zyssai/GPIO-4-Cars/README.md

# GPIO'4'Cars

This project, named GPIO'4'Cars, was designed to easily connect your Odroid N2/N2+ board, with your car.

More information here:

https://forum.odroid.com/viewtopic.php?f=182&t=45350
