zyssai/GPIO-4-Cars/howto/Howto_bootanim.txt

remount
cp /storage/emulated/0/Download/boot-logo.bmp.gz /odm/
chmod 755 /odm/boot-logo.bmp.gz
cp /storage/emulated/0/Download/bootanimation.zip /system/product/media/
chmod 755 /system/product/media/bootanimation.zip
