zyssai/GPIO-4-Cars/howto/Howto_root.txt

install magisk apk:

https://github.com/topjohnwu/Magisk/releases

From computer, connected with usb otg port:

adb shell

cd /storage/emulated/0/Download

dd if=/dev/block/boot of=boot.img

* patch boot.img with magisk app

dd of=/dev/block/boot if=patched_boot.img
