zyssai/GPIO-4-Cars/v1.5c/Laguna3_SWC_wiring.png

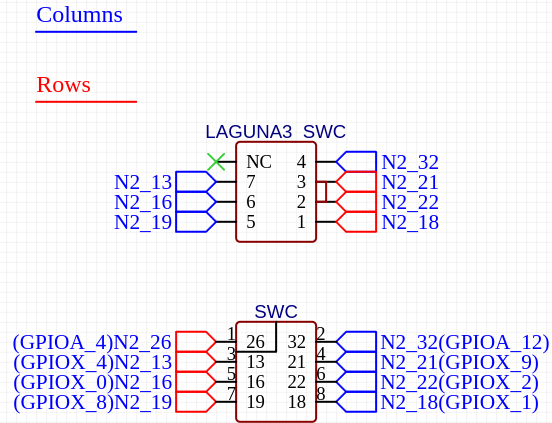
v1.5c/Laguna3_SWC_wiring.png
