zyssai/GPIO-4-Cars/v1.5c/Schematic_GPIO'4'Cars_v1.5c_2024-02-28.pdf

## GPIO INPUTS

## POWER MOSFET

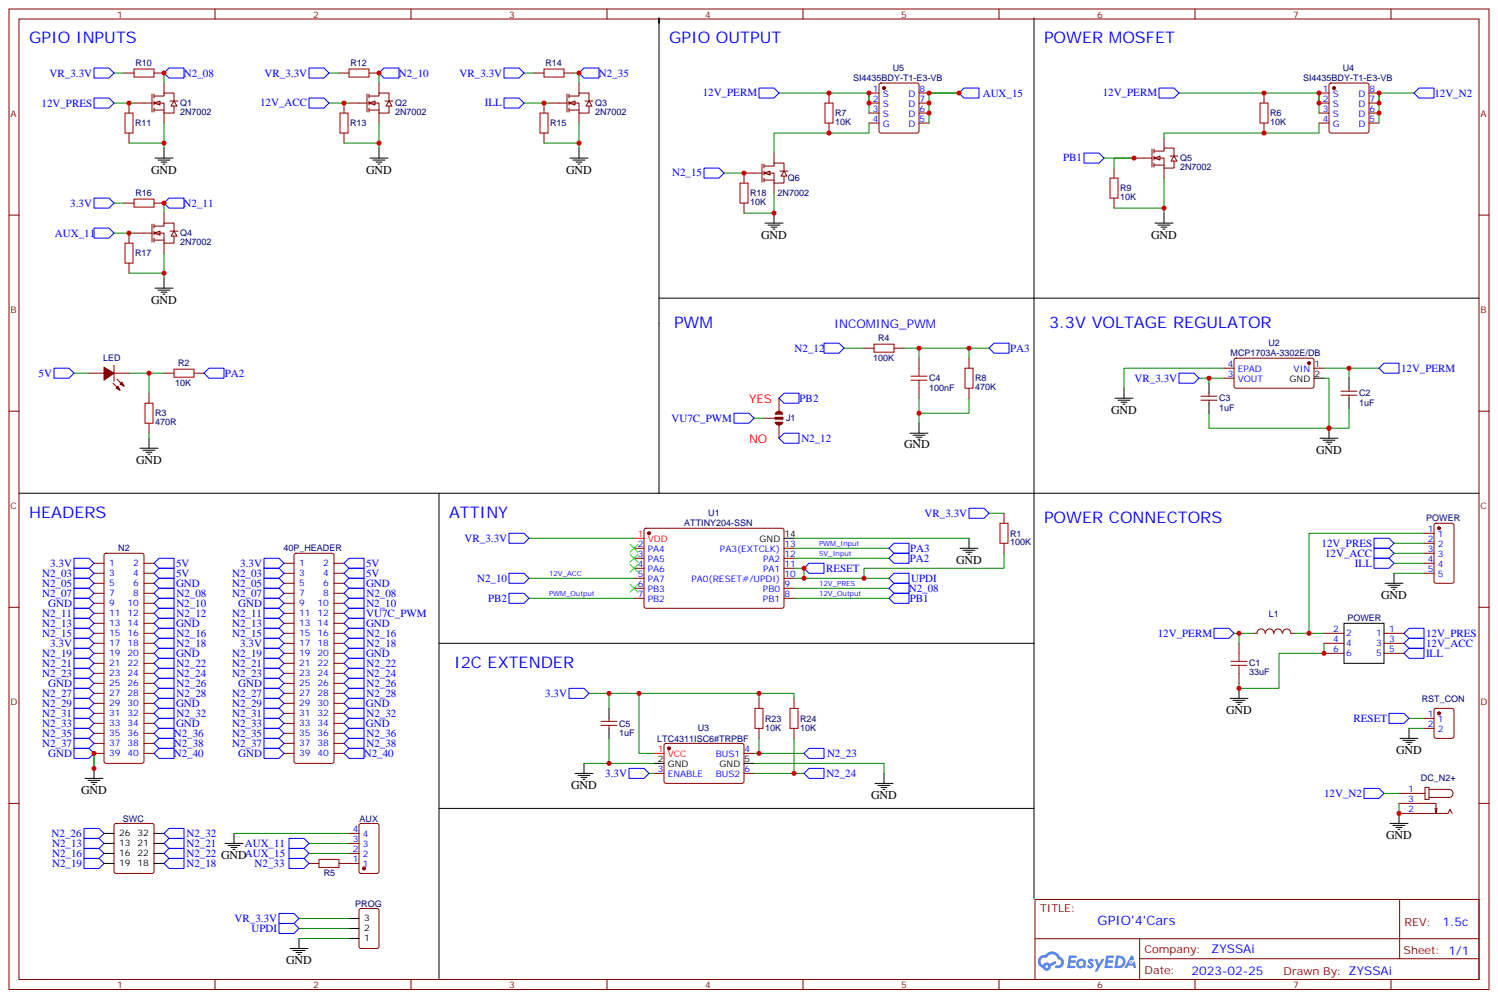
[picture p2: page 1]

PA0(RESET#/UPDI) 10 PA1 11 PA2 12 PA3(EXTCLK) 13 GND 14 VR_3.3V
