zyssai/GPIO-4-Cars/Schematic_GPIO'4'Cars v1.4_Lag_2023-06-18.pdf

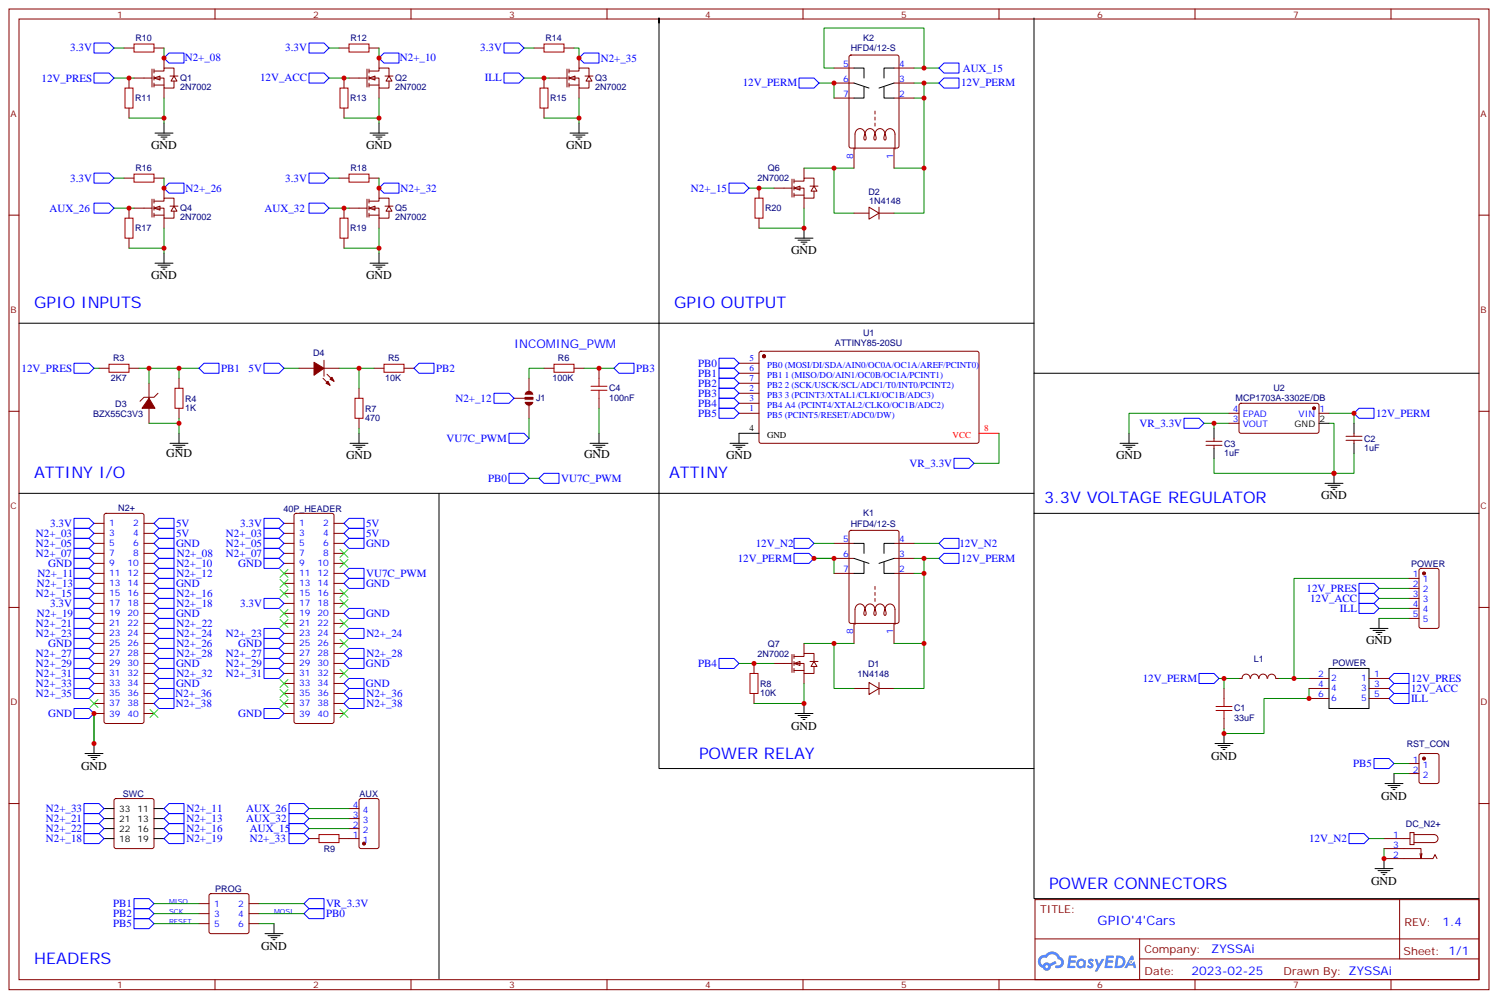
[picture p3: page 1]
