zyssai/GPIO-4-Cars/(commit log)

2022-12-11 IDE sketch and PDE Processing file for Arduino UNO R3 multichannel Oscilloscope
2022-12-28 Arduino IDE working code
2022-12-30 Arduino Pro Mini as ISP
2022-12-30 Arduino UNO Logic Analyzer
2022-12-30 Arduino UNO Oscilloscope
2023-01-24 lowered i2c clock speed to prevent bad vu7c initialization
2023-01-25 lower speed of i2c bus for better stability
2023-12-23 Update GPIO_4_CARS.ino
    PWM high backlight at start corrected.
2024-02-05 Create Attiny204.ino
    New code.
    PWM not tested
2024-02-13 1.5b working with PWM
2024-04-19 rename to keymatrix.dtbo
    Please see wiring schematic for Renault Laguna 3
